Tsquash/AirQualityMonitor/Production/DigikeyBOM - QTY 1.csv

Index | Quantity | Part Number | Manufacturer Part Number | Description | Customer Reference | Available | Backorder | Unit Price | Extended Price USD
1 | 1 | BAT-HLD-001-ND | BAT-HLD-001 | BATTERY RETAINER COIN 20MM SMD |  | 1 | 0 | 0.38000 | 0.38
2 | 12 | 399-C0603C105K4RACTUCT-ND | C0603C105K4RACTU | CAP CER 1UF 16V X7R 0603 |  | 12 | 0 | 0.01100 | 0.13
3 | 10 | 1276-1784-1-ND | CL10A475KO8NNNC | CAP CER 4.7UF 16V X5R 0603 |  | 10 | 0 | 0.01400 | 0.14
4 | 1 | 1276-CL10E104KC8VPNCCT-ND | CL10E104KC8VPNC | CAP CER 100NF 100V X8L 0603 |  | 1 | 0 | 0.25000 | 0.25
5 | 1 | 1276-6769-1-ND | CL10X106MO8NRNC | CAP CER 10UF 16V X6S 0603 |  | 1 | 0 | 0.11000 | 0.11
6 | 2 | 1276-CL10E224KA84PNCCT-ND | CL10E224KA84PNC | CAP CER 220NF 25V X8L 0603 |  | 2 | 0 | 0.16000 | 0.32
7 | 3 | 5399-1N5819WCT-ND | 1N5819W | 40V INDEPENDENT TYPE 1A 900MV@3A |  | 3 | 0 | 0.10000 | 0.30
8 | 1 | 26-FH34SRJ-24S-0.5SH(50)CT-ND | FH34SRJ-24S-0.5SH(50) | CONN FFC FPC 24POS 0.5MM R/A |  | 1 | 0 | 1.01000 | 1.01
9 | 1 | 2223-UJ20-C-V-C-1-SMT-TRCT-ND | UJ20-C-V-C-1-SMT-TR | USB JACK 2.0, TYPE-C, VERTICAL, |  | 1 | 0 | 0.76000 | 0.76
10 | 1 | 587-1816-1-ND | LBM2016T680J | FIXED IND 68UH 90MA 7 OHM SMD |  | 1 | 0 | 0.12000 | 0.12
11 | 1 | SI1308EDL-T1-GE3CT-ND | SI1308EDL-T1-GE3 | MOSFET N-CH 30V 1.4A SOT323 |  | 1 | 0 | 0.58000 | 0.58
12 | 10 | 311-4.70KHRCT-ND | RC0603FR-074K7L | RES 4.7K OHM 1% 1/10W 0603 |  | 10 | 0 | 0.00900 | 0.09
13 | 1 | 60-73L2R47JCT-ND | 73L2R47J | RES 0.47 OHM 5% 1/10W 0603 |  | 1 | 0 | 0.10000 | 0.10
14 | 10 | 311-10.0KHRCT-ND | RC0603FR-0710KL | RES 10K OHM 1% 1/10W 0603 |  | 10 | 0 | 0.00600 | 0.06
15 | 25 | 311-100KHRCT-ND | RC0603FR-07100KL | RES 100K OHM 1% 1/10W 0603 |  | 25 | 0 | 0.00520 | 0.13
16 | 1 | 311-4.7GRCT-ND | RC0603JR-074R7L | RES 4.7 OHM 5% 1/10W 0603 |  | 1 | 0 | 0.10000 | 0.10
17 | 10 | 311-5.10KHRCT-ND | RC0603FR-075K1L | RES 5.1K OHM 1% 1/10W 0603 |  | 10 | 0 | 0.00700 | 0.07
18 | 2 | EG4389CT-ND | TL3330AF260QG | SWITCH TACTILE SPST-NO 0.05A 12V |  | 2 | 0 | 0.53000 | 1.06
19 | 1 | 1649-SCD41-D-R2CT-ND | SCD41-D-R2 | SENSOR AIR QUALITY I2C OUTPUT |  | 1 | 0 | 19.76000 | 19.76
20 | 1 | 1528-5183-ND | 5183 | DHT20 - AHT20 PIN MODULE - I2C T |  | 1 | 0 | 4.50000 | 4.50
21 | 1 | 175-MAX31328NELB+TCT-ND | MAX31328NELB+T | INTEGRATED DS3231SN W/ NDK CRYST |  | 1 | 0 | 4.94000 | 4.94
22 | 1 | 1649-SGP41-D-R4CT-ND | SGP41-D-R4 | SENSOR AIR QUALITY I2C OUTPUT |  | 1 | 0 | 8.18000 | 8.18
