Tsquash/AirQualityMonitor/2D/PCB.dxf

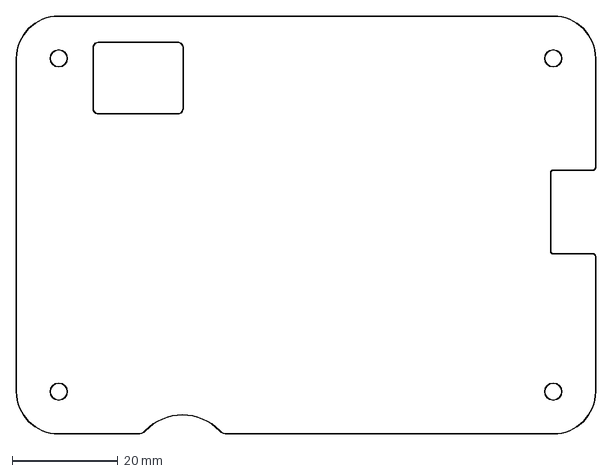
[picture p1: CAD file, 2026-10-28]
2D/PCB.dxf
109.5 x 79.0 mm
