Tsquash/AirQualityMonitor/3D/PCB Spacer.stl

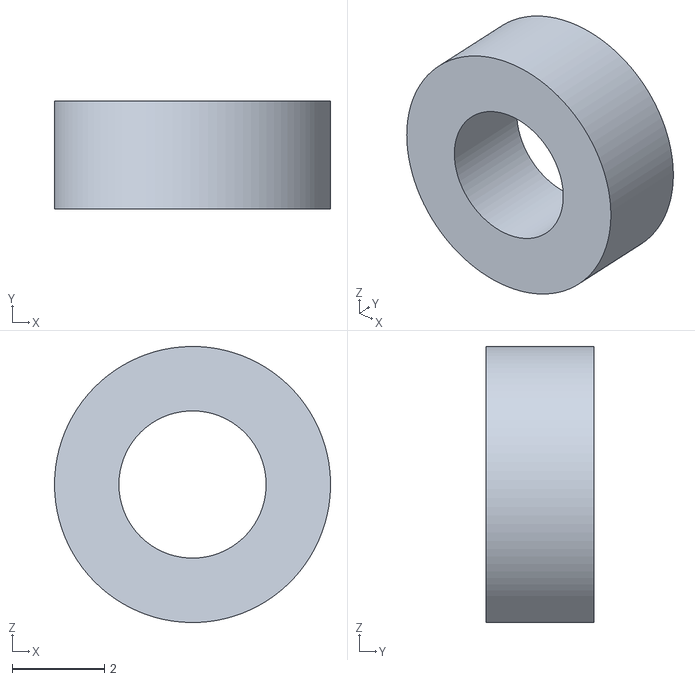
[picture p2: CAD file, 2026-10-28]
3D/PCB Spacer.stl
6.00 x 2.35 x 6.00
