Tsquash/AirQualityMonitor/KICAD/Parts/DHT/DHTVertical_Footprint.dxf

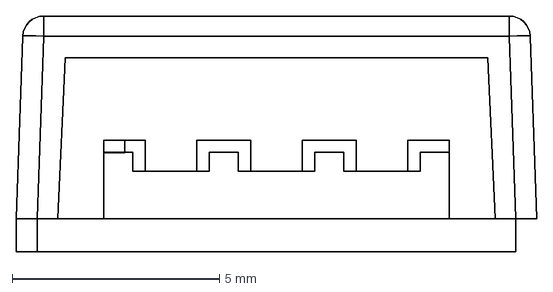
[picture p3: CAD file, 2026-10-28]
KICAD/Parts/DHT/DHTVertical_Footprint.dxf
12.6 x 5.69 mm
