Tsquash/AirQualityMonitor/KICAD/Parts/RTC/21-0140AK_L1055M-1_MXM.step

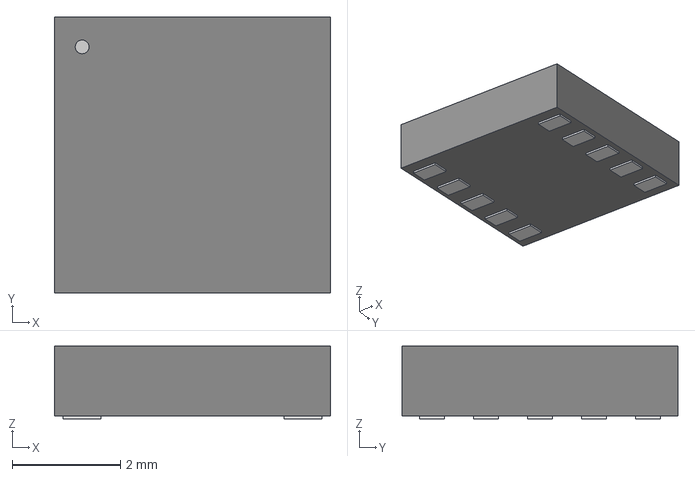
[picture p4: CAD file, 2026-10-28]
KICAD/Parts/RTC/21-0140AK_L1055M-1_MXM.step
5.11 x 5.11 x 1.35 mm
