Tsquash/AirQualityMonitor/KICAD/Parts/UJ20_C_V_C_1_SMT_TR/UJ20-C-V-C-1-SMT-TR.step

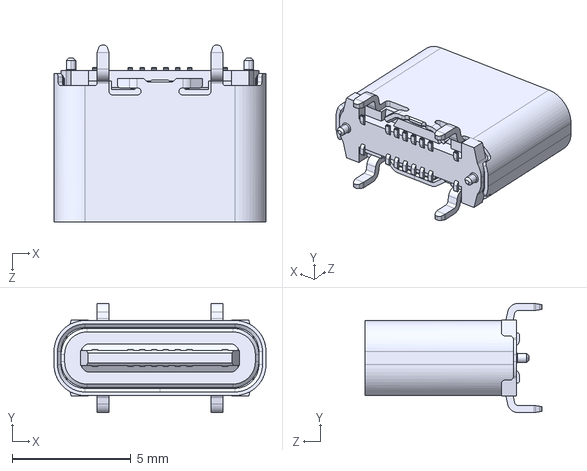
[picture p5: CAD file, 2026-10-28]
KICAD/Parts/UJ20_C_V_C_1_SMT_TR/UJ20-C-V-C-1-SMT-TR.step
8.94 x 4.60 x 7.45 mm
