Tsquash/AirQualityMonitor/2D/3.7EPD.dxf

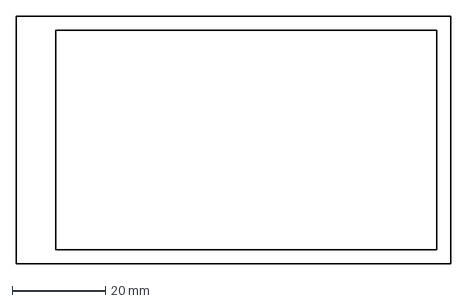
[picture p6: CAD file, 2026-10-28]
2D/3.7EPD.dxf
93.0 x 53.0 mm
