Tsquash/AirQualityMonitor/3D/PCB.step

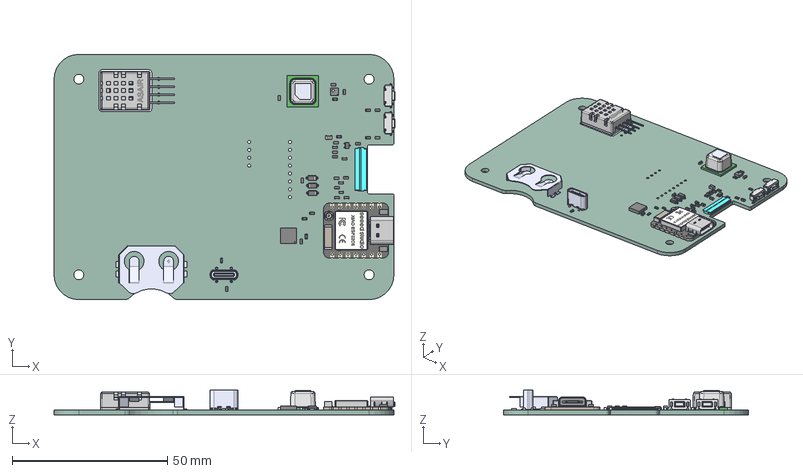
[picture p7: CAD file, 2026-10-28]
3D/PCB.step
109.9 x 79.0 x 8.00 mm
C_0603_1608Metric x 18
UJ20-C-V-C-1-SMT-TR
SOT-323_SC-70
21-0140AK_L1055M-1_MXM
R_0603_1608Metric x 11
FH34SRJ-24S-0.5SH
D_SOD-123 x 3
TL3330AF130QG--3DModel-STEP-520916 x 2
BAT-HLD-001
BOSS-EXTRUDE14_8_
BOSS-EXTRUDE7_4_
BOSS-EXTRUDE7_3_
BOSS-EXTRUDE14_4_
BOSS-EXTRUDE14_2_
BOSS-EXTRUDE14_11_
BOSS-EXTRUDE7_7_
BOSS-EXTRUDE14_9_
BOSS-EXTRUDE14_3_
BOSS-EXTRUDE14_7_
MIRROR2
BOSS-EXTRUDE14_5_
BOSS-EXTRUDE14_12_
BOSS-EXTRUDE7_8_
BOSS-EXTRUDE7_1_
BOSS-EXTRUDE14_10_
BOSS-EXTRUDE7_9_
BOSS-EXTRUDE14_6_
BOSS-EXTRUDE14_1_
BOSS-EXTRUDE7_6_
BOSS-EXTRUDE7_2_
CUT-EXTRUDE5
BOSS-EXTRUDE7_5_
Shield
Pins x 2
U.FL-R-SMT-1_10_ v1
L_0805_2012Metric
ASAIR DHT20 SIP
SCD41-D-R2
SGP41-D-R4
AirQuality_PCB
