Tsquash/AirQualityMonitor/KICAD/Parts/DHT/DHT20 Footprint.dxf

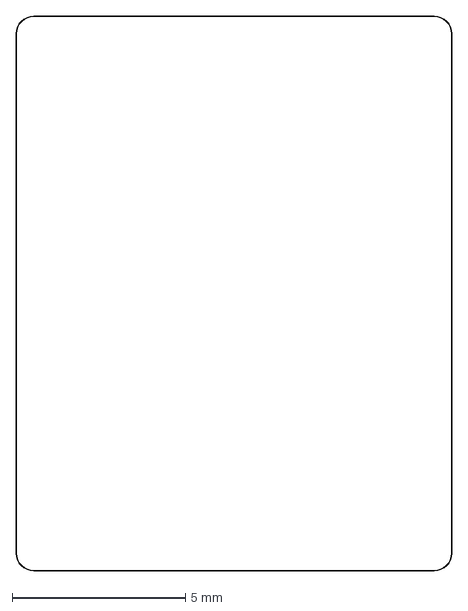
[picture p8: CAD file, 2026-10-28]
KICAD/Parts/DHT/DHT20 Footprint.dxf
12.6 x 16.0 mm
