Tsquash/AirQualityMonitor/2D/BackDXF.dxf

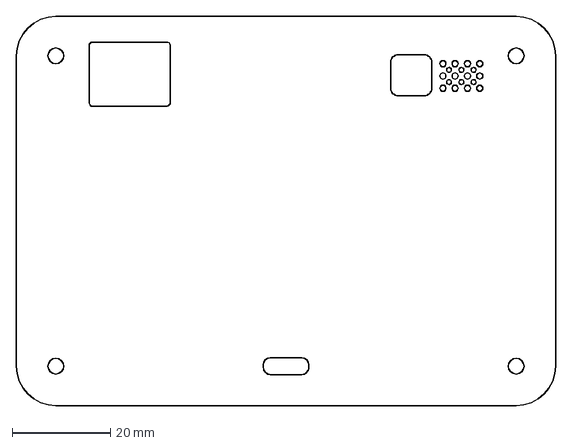
[picture p9: CAD file, 2026-10-28]
2D/BackDXF.dxf
109.5 x 79.0 mm
