Tsquash/AirQualityMonitor/3D/Back Spacer.stl

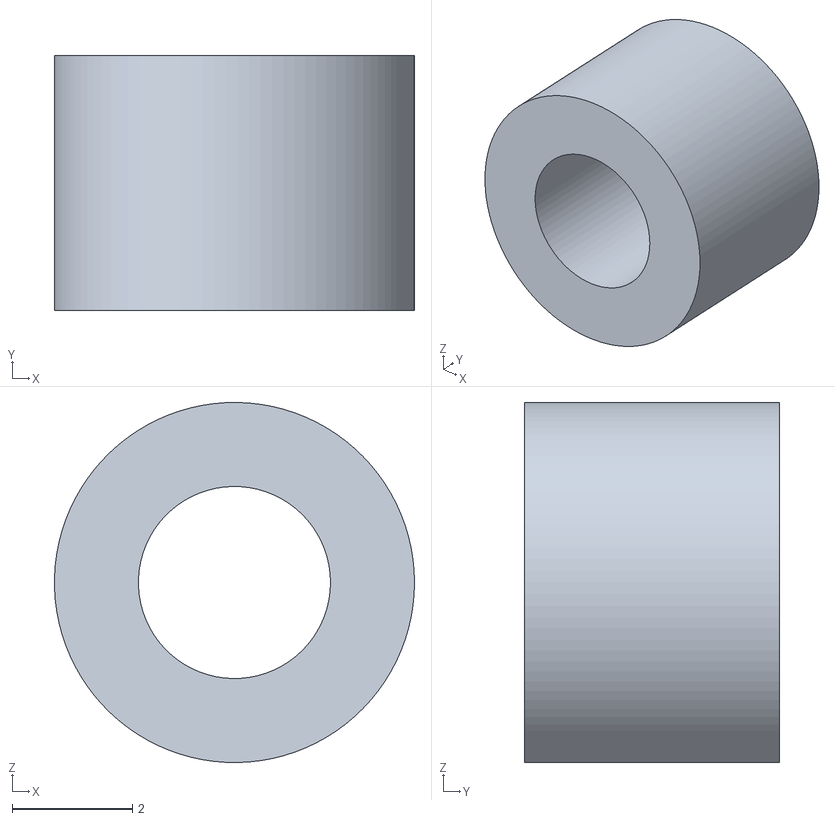
[picture p10: CAD file, 2026-10-28]
3D/Back Spacer.stl
6.00 x 4.25 x 6.00
