Tsquash/AirQualityMonitor/KICAD/Parts/DHT/ASAIR DHT20 SIP .step

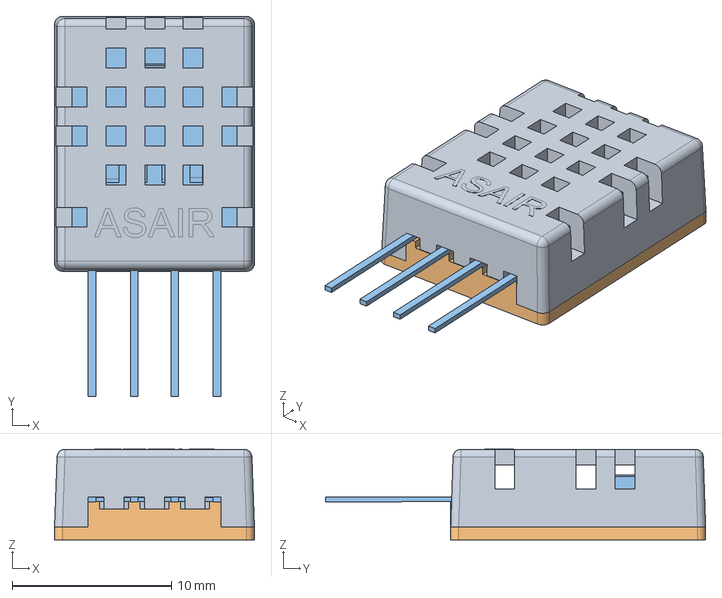
[picture p11: CAD file, 2026-10-28]
KICAD/Parts/DHT/ASAIR DHT20 SIP .step
12.6 x 23.9 x 5.71 mm
