Tsquash/AirQualityMonitor/2D/FrontDXF.dxf

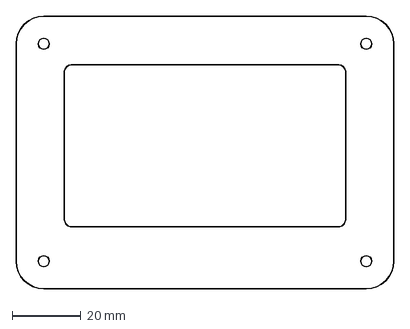
[picture p12: CAD file, 2026-10-28]
2D/FrontDXF.dxf
109.5 x 79.0 mm
