Tsquash/AirQualityMonitor/KICAD/AirQuality.kicad_pcb

## KiCad design KICAD/AirQuality.kicad_pcb (2026-10-28)

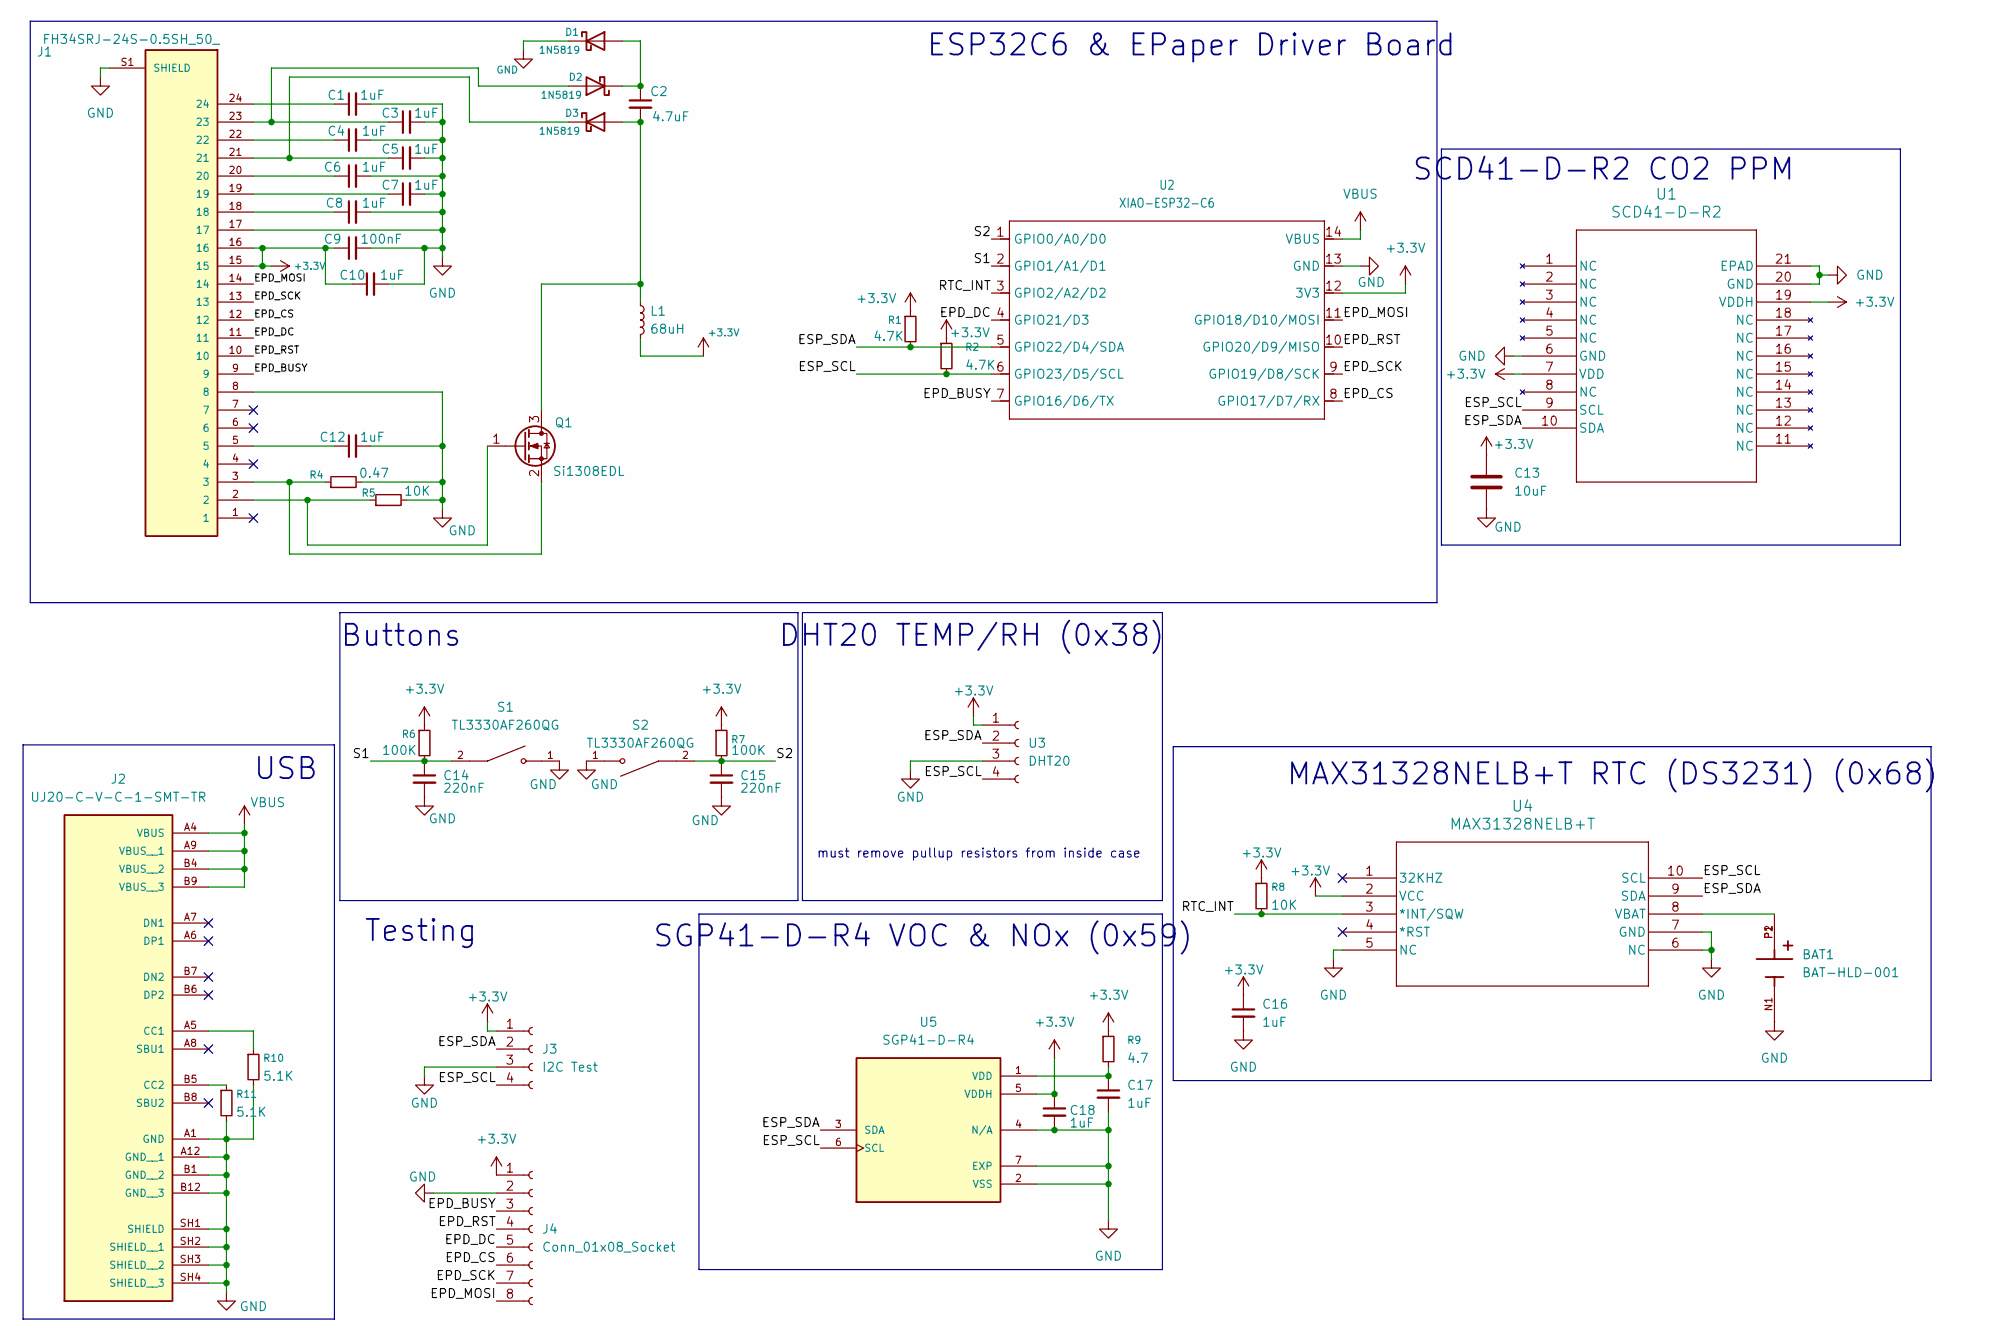
[picture p13: schematic AirQuality.kicad_sch]

Parts:
BAT1: BAT-HLD-001; BAT_BAT-HLD-001; PARTREV C
C1, C3, C4, C5, C6, C7, C8, C10, C12, C16, C17, C18: 1uF; C_0603_1608Metric
C2: 4.7uF; C_0603_1608Metric
C9: 100nF; C_0603_1608Metric
C13: 10uF; C_0603_1608Metric
C14, C15: 220nF; C_0603_1608Metric
D1, D2, D3: 1N5819; D_SOD-123
J1: FH34SRJ-24S-0.5SH_50_; HRS_FH34SRJ-24S-0.5SH_50_
J2: UJ20-C-V-C-1-SMT-TR; CUI_UJ20-C-V-C-1-SMT-TR; PARTREV 1.0
J3: I2C Test; PinHeader_1x04_P2.54mm_Vertical
J4: Conn_01x08_Socket; PinHeader_1x08_P2.54mm_Vertical
L1: 68uH; L_0805_2012Metric
Q1: Si1308EDL; SOT-323_SC-70
R1, R2: 4.7K; R_0603_1608Metric
R4: 0.47; R_0603_1608Metric
R5, R8: 10K; R_0603_1608Metric
R6, R7: 100K; R_0603_1608Metric
R9: 4.7; R_0603_1608Metric
R10, R11: 5.1K; R_0603_1608Metric
S1, S2: TL3330AF260QG; SW_TL3330AF260QG; PARTREV B
U1: SCD41-D-R2; QFN20_SCD41-D-R2_SEN
U2: XIAO-ESP32-C6; XIAO-ESP32C6-DIP
U3: DHT20; PinHeader_1x04_P2.54mm_Vertical
U4: MAX31328NELB+T; 21-0140AK_L1055M-1_MXM
U5: SGP41-D-R4; XDCR_SGP41-D-R4; PARTREV 1.0

Connections:
+3.3V: C9.1, C10.1, C13.1, C16.1, C18.1, J1.15, J1.16, J3.1, J4.1, L1.2, R1.1, R2.1, R6.1, R7.1, R8.1, R9.1, U1.7 (VDD), U1.19 (VDDH), U2.12 (3V3), U3.1, U4.2 (VCC), U5.5 (VDDH); also elsewhere on the board
/EPD_BUSY: J1.9, J4.3, U2.7 (GPIO16/D6/TX)
/EPD_CS: J1.12, J4.6, U2.8 (GPIO17/D7/RX)
/EPD_DC: J1.11, J4.5, U2.4 (GPIO21/D3)
/EPD_MOSI: J1.14, J4.8, U2.11 (GPIO18/D10/MOSI)
/EPD_RST: J1.10, J4.4, U2.10 (GPIO20/D9/MISO)
/EPD_SCK: J1.13, J4.7, U2.9 (GPIO19/D8/SCK)
/ESP_SCL: J3.4, R2.2, U1.9 (SCL), U2.6 (GPIO23/D5/SCL), U3.4, U4.10 (SCL), U5.6 (SCL)
/ESP_SDA: J3.2, R1.2, U1.10 (SDA), U2.5 (GPIO22/D4/SDA), U3.2, U4.9 (SDA), U5.3 (SDA)
/RTC_INT: R8.2, U2.3 (GPIO2/A2/D2), U4.3 (*INT/SQW)
/S1: C14.1, R6.2, S1.2, U2.2 (GPIO1/A1/D1)
/S2: C15.1, R7.2, S2.2, U2.1 (GPIO0/A0/D0)
GND: BAT1.N1, C1.2, C3.2, C4.2, C5.2, C6.2, C7.2, C8.2, C9.2, C10.2, C12.2, C13.2, C14.2, C15.2, C16.2, C17.2, C18.2, D1.1 (K), J1.8, J1.17, J1.S1 (SHIELD), J1.S2 (SHIELD), J2.A1 (GND), J2.A12 (GND__1), J2.B1 (GND__2), J2.B12 (GND__3), J2.SH1 (SHIELD), J2.SH2 (SHIELD__1), J2.SH3 (SHIELD__2), J2.SH4 (SHIELD__3), J3.3, J4.2, R4.2, R5.2, R10.2, R11.2, S1.1, S2.1, U1.6 (GND), U1.20 (GND), U1.21 (EPAD), U2.13 (GND), U3.3, U4.5 (NC), U4.6 (NC), U4.7 (GND), U5.2 (VSS), U5.4 (N/A), U5.7 (EXP); also elsewhere on the board
unnamed: C1.1, J1.24
unnamed: C4.1, J1.22
unnamed: C6.1, J1.20
unnamed: C7.1, J1.19
unnamed: C8.1, J1.18
unnamed: C12.1, J1.5
unnamed: C2.1, D1.2 (A), D2.1 (K)
unnamed: C3.1, D2.2 (A), J1.23
unnamed: C2.2, D3.2 (A), L1.1, Q1.3 (D)
unnamed: C5.1, D3.1 (K), J1.21
unnamed 23: J1.4; also elsewhere on the board
unnamed: J2.A5 (CC1), R10.1
unnamed: J2.B5 (CC2), R11.1
unnamed: J1.2, Q1.1 (G), R5.1
unnamed: J1.3, Q1.2 (S), R4.1
unnamed: BAT1.P1, BAT1.P2, U4.8 (VBAT)
unnamed: C17.1, R9.2, U5.1 (VDD)
VBUS: J2.A4 (VBUS), J2.A9 (VBUS__1), J2.B4 (VBUS__2), J2.B9 (VBUS__3), U2.14 (VBUS)

Notes on the sheet:
SGP41-D-R4 VOC & NOx (0x59)
ESP32C6 & EPaper Driver Board
DHT20 TEMP/RH (0x38)
USB
Buttons
Testing
MAX31328NELB+T RTC (DS3231) (0x68)
SCD41-D-R2 CO2 PPM
must remove pullup resistors from inside case

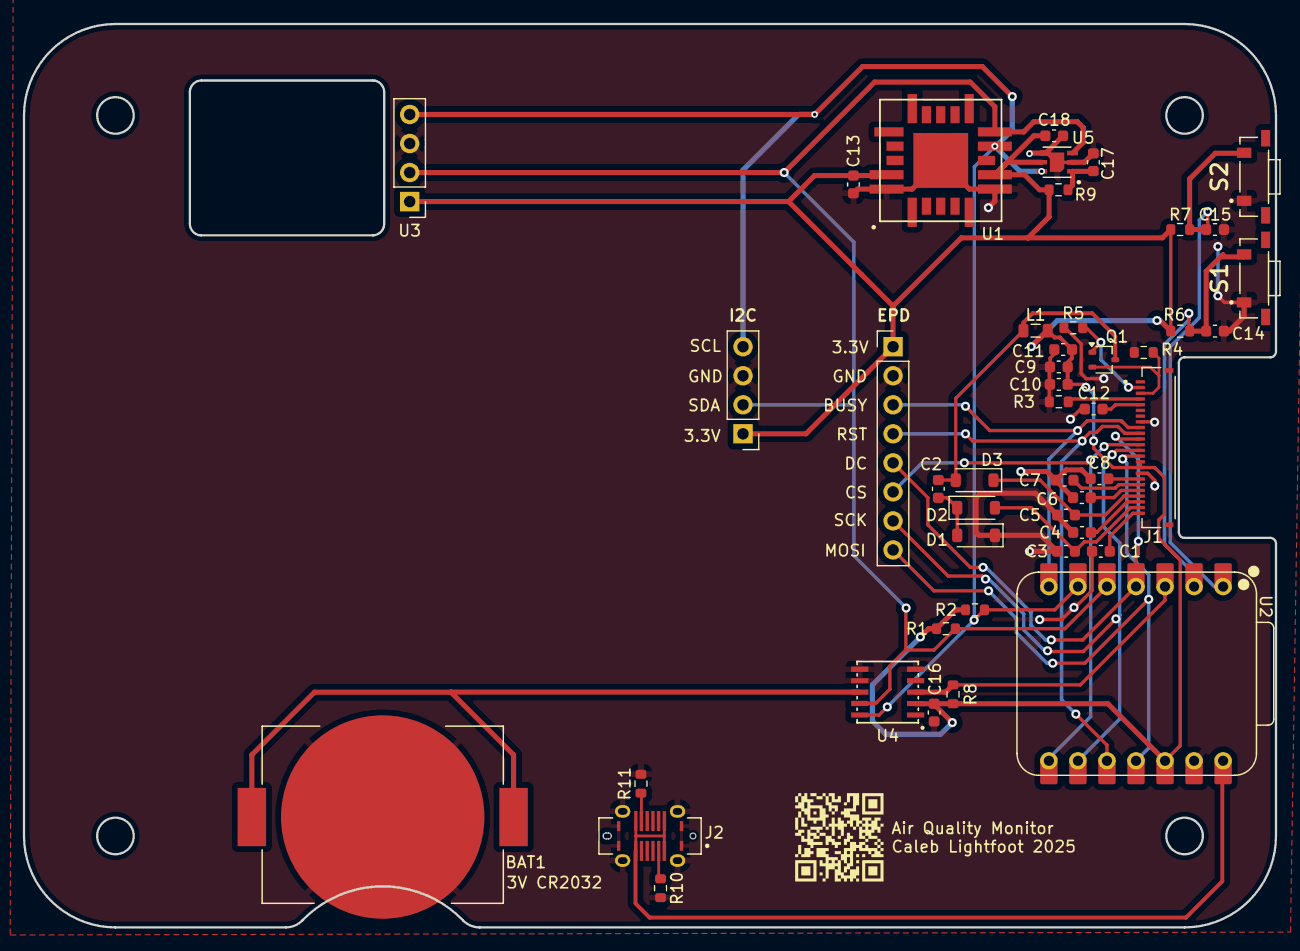
[picture p14: board AirQuality.kicad_pcb from above]

Board: 4 copper layers, 109.5 x 79.0 mm, 46 parts (0 on the bottom side), 31 nets.

Other parts of the board:
C11: 4.7uF; C_0603_1608Metric
R3: 0; R_0603_1608Metric

Their connections:
+3.3V: C11.1; also elsewhere on the board
GND: C11.2, R3.2; also elsewhere on the board
unnamed 23: R3.1; also elsewhere on the board
