Tsquash/AirQualityMonitor/main/matter_air_quality_sensor.cpp

#include "sense.h"
#include "pm_link.h"
#include "matter_air_quality_sensor.h"
#include <platform/CHIPDeviceLayer.h>

float AirQualitySensor::getTemperature() { return tempC; }
float AirQualitySensor::getHumidity() { return (float)RH; }     
float AirQualitySensor::getCO2() { return (float)CO2; }
int32_t AirQualitySensor::getVOCIndex() { return VOC; }
int32_t AirQualitySensor::getNOxIndex() { return NOx; }

using namespace esp_matter;
using namespace esp_matter::endpoint;
using namespace chip::app::Clusters;
using namespace esp_matter::cluster; 

MatterAirQualitySensor::MatterAirQualitySensor(endpoint_t* endpoint, std::shared_ptr<AirQualitySensor> airQualitySensor)
    : m_endpoint(endpoint), m_airQualitySensor(airQualitySensor) {}

std::shared_ptr<MatterAirQualitySensor> MatterAirQualitySensor::CreateEndpoint(
    node_t* node, 
    std::shared_ptr<AirQualitySensor> airQualitySensor) 
{
    // 1. Create the base Air Quality Endpoint
    air_quality_sensor::config_t air_quality_config;
    endpoint_t* endpoint = air_quality_sensor::create(node, &air_quality_config, ENDPOINT_FLAG_NONE, nullptr);

    if (!endpoint) {
        log_e("Failed to create Air Quality endpoint!");
        return nullptr;
    }

    // Advertise every AirQuality enum value used by our six-band calculation.
    cluster_t *quality_cluster = cluster::get(endpoint, AirQuality::Id);
    // This SDK's feature helper declarations do not match their linked names.
    // These four bits enable Fair, Moderate, VeryPoor, and ExtremelyPoor.
    attribute_t *quality_features = attribute::get(quality_cluster, Globals::Attributes::FeatureMap::Id);
    esp_matter_attr_val_t quality_feature_value = esp_matter_uint32(0x0F);
    if (!quality_features || attribute::set_val(quality_features, &quality_feature_value) != ESP_OK)
        return nullptr;

    // 2. Add Device Types
    endpoint::add_device_type(endpoint, 0x0302, 1); // Temperature Sensor
    endpoint::add_device_type(endpoint, 0x0307, 1); // Humidity Sensor

    // -------------------------------------------------------------------------
    // TEMPERATURE
    // -------------------------------------------------------------------------
    temperature_measurement::config_t temp_config;
    temp_config.measured_value = nullable<int16_t>(0);
    temp_config.min_measured_value = nullable<int16_t>(-4000);
    temp_config.max_measured_value = nullable<int16_t>(8500);
    cluster_t *temp_cluster = temperature_measurement::create(endpoint, &temp_config, CLUSTER_FLAG_SERVER);
    if (!temp_cluster)
        return nullptr;

    // -------------------------------------------------------------------------
    // HUMIDITY
    // -------------------------------------------------------------------------
    relative_humidity_measurement::config_t humid_config;
    humid_config.measured_value = nullable<uint16_t>(0);
    humid_config.min_measured_value = nullable<uint16_t>(0);
    humid_config.max_measured_value = nullable<uint16_t>(10000);
    cluster_t *humid_cluster = relative_humidity_measurement::create(endpoint, &humid_config, CLUSTER_FLAG_SERVER);
    if (!humid_cluster)
        return nullptr;

    // -------------------------------------------------------------------------
    // CO2 (Concentration Measurement)
    // -------------------------------------------------------------------------
    carbon_dioxide_concentration_measurement::config_t co2_config;

    cluster_t *co2_cluster = carbon_dioxide_concentration_measurement::create(endpoint, &co2_config, CLUSTER_FLAG_SERVER);

    // Enable NumericMeasurement, LevelIndication, MediumLevel, and CriticalLevel.
    attribute_t *featureMapAttr = attribute::get(co2_cluster, 0xFFFC); // 0xFFFC is the standard FeatureMap ID
    if (featureMapAttr) {
        esp_matter_attr_val_t val = esp_matter_uint32(0x0F);
        attribute::set_val(featureMapAttr, &val);
    }

    // Mandatory Attributes for Numeric Mode:
    attribute::create(co2_cluster, CarbonDioxideConcentrationMeasurement::Attributes::MinMeasuredValue::Id, ATTRIBUTE_FLAG_NULLABLE, esp_matter_float(0.0));
    attribute::create(co2_cluster, CarbonDioxideConcentrationMeasurement::Attributes::MaxMeasuredValue::Id, ATTRIBUTE_FLAG_NULLABLE, esp_matter_float(5000.0));
    attribute::create(co2_cluster, CarbonDioxideConcentrationMeasurement::Attributes::MeasuredValue::Id, ATTRIBUTE_FLAG_NULLABLE, esp_matter_float(0.0));

    // Measurement Unit (0x0004) -> PPM (0)
    attribute::create(co2_cluster, CarbonDioxideConcentrationMeasurement::Attributes::MeasurementUnit::Id, ATTRIBUTE_FLAG_NULLABLE, esp_matter_uint8(0));

    // Add VOC and NOx clusters to the Matter endpoint
    // -------------------------------------------------------------------------
    // VOC (tVOC Measurement)
    // -------------------------------------------------------------------------
    total_volatile_organic_compounds_concentration_measurement::config_t voc_config;
    cluster_t *voc_cluster = total_volatile_organic_compounds_concentration_measurement::create(
        endpoint, &voc_config, CLUSTER_FLAG_SERVER);

    attribute_t *vocFeatureMapAttr = attribute::get(voc_cluster, 0xFFFC);
    if (vocFeatureMapAttr) {
        esp_matter_attr_val_t val = esp_matter_uint32(0x0F);
        attribute::set_val(vocFeatureMapAttr, &val);
    }

    attribute::create(voc_cluster, TotalVolatileOrganicCompoundsConcentrationMeasurement::Attributes::MinMeasuredValue::Id,
                      ATTRIBUTE_FLAG_NULLABLE, esp_matter_float(1.0));
    attribute::create(voc_cluster, TotalVolatileOrganicCompoundsConcentrationMeasurement::Attributes::MaxMeasuredValue::Id,
                      ATTRIBUTE_FLAG_NULLABLE, esp_matter_float(500.0));
    attribute::create(voc_cluster, TotalVolatileOrganicCompoundsConcentrationMeasurement::Attributes::MeasuredValue::Id,
                      ATTRIBUTE_FLAG_NULLABLE, esp_matter_float(1.0));
    attribute::create(voc_cluster, TotalVolatileOrganicCompoundsConcentrationMeasurement::Attributes::MeasurementUnit::Id,
                      ATTRIBUTE_FLAG_NULLABLE, esp_matter_uint8(4)); // ug/m3
    attribute::create(voc_cluster, TotalVolatileOrganicCompoundsConcentrationMeasurement::Attributes::MeasurementMedium::Id,
                      ATTRIBUTE_FLAG_NULLABLE, esp_matter_uint8(0)); // air

    // -------------------------------------------------------------------------
    // NOx (NO2 Measurement)
    // -------------------------------------------------------------------------
    nitrogen_dioxide_concentration_measurement::config_t nox_config;
    cluster_t *nox_cluster = nitrogen_dioxide_concentration_measurement::create(
        endpoint, &nox_config, CLUSTER_FLAG_SERVER);

    attribute_t *noxFeatureMapAttr = attribute::get(nox_cluster, 0xFFFC);
    if (noxFeatureMapAttr) {
        esp_matter_attr_val_t val = esp_matter_uint32(0x0F);
        attribute::set_val(noxFeatureMapAttr, &val);
    }

    attribute::create(nox_cluster, NitrogenDioxideConcentrationMeasurement::Attributes::MinMeasuredValue::Id,
                      ATTRIBUTE_FLAG_NULLABLE, esp_matter_float(1.0));
    attribute::create(nox_cluster, NitrogenDioxideConcentrationMeasurement::Attributes::MaxMeasuredValue::Id,
                      ATTRIBUTE_FLAG_NULLABLE, esp_matter_float(500.0));
    attribute::create(nox_cluster, NitrogenDioxideConcentrationMeasurement::Attributes::MeasuredValue::Id,
                      ATTRIBUTE_FLAG_NULLABLE, esp_matter_float(1.0));
    attribute::create(nox_cluster, NitrogenDioxideConcentrationMeasurement::Attributes::MeasurementUnit::Id,
                      ATTRIBUTE_FLAG_NULLABLE, esp_matter_uint8(4)); // ug/m3 (wrong unit :( only one that works)
    attribute::create(nox_cluster, NitrogenDioxideConcentrationMeasurement::Attributes::MeasurementMedium::Id,
                      ATTRIBUTE_FLAG_NULLABLE, esp_matter_uint8(0)); // air

    // PM1 in ug/m3, numeric measurement only.
    pm1_concentration_measurement::config_t pm1_config;
    cluster_t *pm1_cluster = pm1_concentration_measurement::create(endpoint, &pm1_config, CLUSTER_FLAG_SERVER);
    pm1_concentration_measurement::feature::numeric_measurement::config_t pm1_numeric;
    pm1_numeric.measured_value = 0.0f;
    pm1_numeric.min_measured_value = 0.0f;
    pm1_numeric.max_measured_value = 1000.0f;
    pm1_numeric.measurement_unit = 4; // ug/m3; measurement medium defaults to air
    if (!pm1_cluster || pm1_concentration_measurement::feature::numeric_measurement::add(pm1_cluster, &pm1_numeric) != ESP_OK)
        return nullptr;

    // PM25 in ug/m3, numeric measurement only.
    pm25_concentration_measurement::config_t pm25_config;
    cluster_t *pm25_cluster = pm25_concentration_measurement::create(endpoint, &pm25_config, CLUSTER_FLAG_SERVER);
    pm25_concentration_measurement::feature::numeric_measurement::config_t pm25_numeric;
    pm25_numeric.measured_value = 0.0f;
    pm25_numeric.min_measured_value = 0.0f;
    pm25_numeric.max_measured_value = 1000.0f;
    pm25_numeric.measurement_unit = 4; // ug/m3; measurement medium defaults to air
    if (!pm25_cluster || pm25_concentration_measurement::feature::numeric_measurement::add(pm25_cluster, &pm25_numeric) != ESP_OK)
        return nullptr;

    // PM10 in ug/m3, numeric measurement only.
    pm10_concentration_measurement::config_t pm10_config;
    cluster_t *pm10_cluster = pm10_concentration_measurement::create(endpoint, &pm10_config, CLUSTER_FLAG_SERVER);
    pm10_concentration_measurement::feature::numeric_measurement::config_t pm10_numeric;
    pm10_numeric.measured_value = 0.0f;
    pm10_numeric.min_measured_value = 0.0f;
    pm10_numeric.max_measured_value = 1000.0f;
    pm10_numeric.measurement_unit = 4; // ug/m3; measurement medium defaults to air
    if (!pm10_cluster || pm10_concentration_measurement::feature::numeric_measurement::add(pm10_cluster, &pm10_numeric) != ESP_OK)
        return nullptr;

    return std::make_shared<MatterAirQualitySensor>(endpoint, airQualitySensor);
}

void MatterAirQualitySensor::UpdateMeasurements() {
    if (!m_airQualitySensor) return;

    // --- Temperature ---
    float temperature = m_airQualitySensor->getTemperature();
    int16_t temp_matter = static_cast<int16_t>(temperature * 100);
    UpdateAttribute(TemperatureMeasurement::Id, TemperatureMeasurement::Attributes::MeasuredValue::Id, temp_matter);

    // --- Humidity ---
    float humidity = m_airQualitySensor->getHumidity();
    uint16_t hum_matter = static_cast<uint16_t>(humidity * 100);
    UpdateAttribute(RelativeHumidityMeasurement::Id, RelativeHumidityMeasurement::Attributes::MeasuredValue::Id, hum_matter);

    // --- CO2 ---
    float co2 = m_airQualitySensor->getCO2();
    UpdateAttribute(CarbonDioxideConcentrationMeasurement::Id, CarbonDioxideConcentrationMeasurement::Attributes::MeasuredValue::Id, co2);

    // --- VOC ---
    float voc = static_cast<float>(m_airQualitySensor->getVOCIndex());
    if (voc < 1.0f) voc = 1.0f;
    if (voc > 500.0f) voc = 500.0f;
    UpdateAttribute(TotalVolatileOrganicCompoundsConcentrationMeasurement::Id,
                    TotalVolatileOrganicCompoundsConcentrationMeasurement::Attributes::MeasuredValue::Id,
                    voc);

    // --- NOx ---
    float nox = static_cast<float>(m_airQualitySensor->getNOxIndex());
    if (nox < 1.0f) nox = 1.0f;
    if (nox > 500.0f) nox = 500.0f;
    UpdateAttribute(NitrogenDioxideConcentrationMeasurement::Id,
                    NitrogenDioxideConcentrationMeasurement::Attributes::MeasuredValue::Id,
                    nox);

    UpdateAttribute(Pm1ConcentrationMeasurement::Id, Pm1ConcentrationMeasurement::Attributes::MeasuredValue::Id, static_cast<float>(remotePM.pm1));
    UpdateAttribute(Pm25ConcentrationMeasurement::Id, Pm25ConcentrationMeasurement::Attributes::MeasuredValue::Id, static_cast<float>(remotePM.pm25));
    UpdateAttribute(Pm10ConcentrationMeasurement::Id, Pm10ConcentrationMeasurement::Attributes::MeasuredValue::Id, static_cast<float>(remotePM.pm10));
    UpdateAttribute(AirQuality::Id, AirQuality::Attributes::AirQuality::Id, getOverallAirQuality());

}

void MatterAirQualitySensor::UpdateAttribute(uint32_t clusterId, uint32_t attributeId, float value) {
    esp_matter_attr_val_t val = esp_matter_float(value);
    
    chip::DeviceLayer::PlatformMgr().LockChipStack();
    esp_err_t err = attribute::update(endpoint::get_id(m_endpoint), clusterId, attributeId, &val);
    if (err != ESP_OK) log_e("Matter update cluster=0x%lx attribute=0x%lx failed: %s", (unsigned long)clusterId, (unsigned long)attributeId, esp_err_to_name(err));
    chip::DeviceLayer::PlatformMgr().UnlockChipStack();
}

void MatterAirQualitySensor::UpdateAttribute(uint32_t clusterId, uint32_t attributeId, uint16_t value) {
    esp_matter_attr_val_t val = esp_matter_uint16(value);
    
    chip::DeviceLayer::PlatformMgr().LockChipStack();
    esp_err_t err = attribute::update(endpoint::get_id(m_endpoint), clusterId, attributeId, &val);
    if (err != ESP_OK) log_e("Matter update cluster=0x%lx attribute=0x%lx failed: %s", (unsigned long)clusterId, (unsigned long)attributeId, esp_err_to_name(err));
    chip::DeviceLayer::PlatformMgr().UnlockChipStack();
}

void MatterAirQualitySensor::UpdateAttribute(uint32_t clusterId, uint32_t attributeId, int16_t value) {
    esp_matter_attr_val_t val = esp_matter_int16(value);
    
    chip::DeviceLayer::PlatformMgr().LockChipStack();
    esp_err_t err = attribute::update(endpoint::get_id(m_endpoint), clusterId, attributeId, &val);
    if (err != ESP_OK) log_e("Matter update cluster=0x%lx attribute=0x%lx failed: %s", (unsigned long)clusterId, (unsigned long)attributeId, esp_err_to_name(err));
    chip::DeviceLayer::PlatformMgr().UnlockChipStack();
}

void MatterAirQualitySensor::UpdateAttribute(uint32_t clusterId, uint32_t attributeId, uint8_t value) {
    esp_matter_attr_val_t val = esp_matter_uint8(value);
    
    chip::DeviceLayer::PlatformMgr().LockChipStack();
    esp_err_t err = attribute::update(endpoint::get_id(m_endpoint), clusterId, attributeId, &val);
    if (err != ESP_OK) log_e("Matter update cluster=0x%lx attribute=0x%lx failed: %s", (unsigned long)clusterId, (unsigned long)attributeId, esp_err_to_name(err));
    chip::DeviceLayer::PlatformMgr().UnlockChipStack();
}
