Tsquash/AirQualityMonitor/main/myBitmap/bitmaps.h

#pragma once
#include <Adafruit_GFX.h>

#define TEMP_HEIGHT 24
#define TEMP_WIDTH 12

const unsigned char  tempBitmap[] PROGMEM = {
  0x06, 0x00, 0x0F, 0x00, 0x19, 0x80, 0x19, 0x80, 0x19, 0x80, 0x1B, 0x80, 0x19, 0x80, 0x19, 0x80, 0x1B, 0x80, 0x19, 0x80, 0x19, 0x80, 0x1F, 0x80, 0x1F, 0x80, 0x3F, 0xC0, 0x7F, 0xE0, 0x7F, 0xE0, 0xFF, 0xF0, 0xFF, 0xF0, 0xFF, 0xF0, 0x7F, 0xE0, 0x7F, 0xE0, 0x7F, 0xE0, 0x1F, 0x80, 0x06, 0x00
};

#define HUMIDITY_HEIGHT 23
#define HUMIDITY_WIDTH 18

const unsigned char humidityBitmap[] PROGMEM = {
  0x00, 0xC0, 0x00, 0x01, 0xE0, 0x00, 0x03, 0x30, 0x00, 0x06, 0x18, 0x00, 0x0C, 0x0C, 0x00, 0x18, 0x06, 0x00, 0x30, 0x03, 0x00, 0x30, 0x03, 0x00, 0x60, 0x01, 0x80, 0xC0, 0x00, 0xC0, 0xC0, 0x00, 0xC0, 0xC0, 0x00, 0xC0, 0xC0, 0x00, 0xC0, 0xC0, 0x00, 0xC0, 0xC8, 0x00, 0xC0, 0xC8, 0x00, 0xC0, 0xCC, 0x00, 0xC0, 0x67, 0x01, 0x80, 0x71, 0xC3, 0x80, 0x30, 0x03, 0x00, 0x1E, 0x1E, 0x00, 0x0F, 0xFC, 0x00, 0x01, 0xE0, 0x00
};

#define CO2_HEIGHT 14
#define CO2_WIDTH 29 
const unsigned char co2Bitmap[] PROGMEM = {
  0x7E, 0x0F, 0xC0, 0x00, 0xFE, 0x1F, 0xE0, 0x00, 0xFE, 0x1F, 0xE0, 0x00, 0xC0, 0x18, 0xE0, 0x00, 0xC0, 0x18, 0xE0, 0x00, 0xC0, 0x18, 0xE3, 0xF0, 0xC0, 0x18, 0xE3, 0xF8, 0xFE, 0x1F, 0xE0, 0x18, 0xFE, 0x1F, 0xE0, 0x18, 0x7E, 0x0F, 0xC1, 0xF8, 0x00, 0x00, 0x03, 0x00, 0x00, 0x00, 0x03, 0x00, 0x00, 0x00, 0x03, 0xF0, 0x00, 0x00, 0x03, 0xF8
};

#define VOC_HEIGHT 19
#define VOC_WIDTH 18
const unsigned char vocBitmap[] PROGMEM = {
  0x00, 0xFF, 0xC0, 0x0F, 0xFF, 0xC0, 0x1F, 0x00, 0xC0, 0x38, 0x00, 0xC0, 0x70, 0x00, 0xC0, 0x60, 0x00, 0xC0, 0xC0, 0x00, 0xC0, 0xC0, 0x00, 0xC0, 0xC0, 0x60, 0xC0, 0xC0, 0xE0, 0xC0, 0xC1, 0xC0, 0xC0, 0xC3, 0x80, 0xC0, 0xC7, 0x00, 0xC0, 0xCE, 0x00, 0xC0, 0x7C, 0x01, 0x80, 0x38, 0x03, 0x00, 0x78, 0x07, 0x00, 0xEF, 0xFC, 0x00, 0xC7, 0xF8, 0x00
};

#define NOX_HEIGHT 18
#define NOX_WIDTH 18  
const unsigned char noxBitmap[] PROGMEM = {
  0x3F, 0x00, 0x00, 0x7F, 0x80, 0x00, 0xC1, 0xC0, 0xC0, 0xC0, 0xE1, 0xC0, 0x00, 0x7F, 0x80, 0x00, 0x3F, 0x00, 0x3F, 0x00, 0x00, 0x7F, 0x80, 0x00, 0xE1, 0xC0, 0xC0, 0xC0, 0xE1, 0xC0, 0x00, 0x7F, 0x80, 0x00, 0x3F, 0x00, 0x3E, 0x00, 0x00, 0x7F, 0x80, 0x00, 0xE1, 0xC0, 0xC0, 0xC0, 0xE0, 0xC0, 0x00, 0x7F, 0x80, 0x00, 0x3F, 0x00
};

#define AQ_HEIGHT 21
#define AQ_WIDTH 18
const unsigned char aqBitmap[] PROGMEM = {
  0x00, 0xC0, 0x00, 0x00, 0xC0, 0x00, 0x0C, 0x0C, 0x00, 0x0C, 0x0C, 0x00, 0x00, 0xC0, 0x00, 0xC0, 0xC0, 0xC0, 0xC0, 0x00, 0xC0, 0x0C, 0x0C, 0x00, 0x0C, 0x0C, 0x00, 0xC0, 0xC0, 0xC0, 0xC0, 0xC0, 0xC0, 0x00, 0x00, 0x00, 0x0C, 0x0C, 0x00, 0x0C, 0x0C, 0x00, 0xC0, 0xC0, 0xC0, 0xC0, 0xC0, 0xC0, 0x0C, 0x0C, 0x00, 0x0C, 0x0C, 0x00, 0x00, 0x00, 0x00, 0x00, 0xC0, 0x00, 0x00, 0xC0, 0x00
};

#define XAXIS_HEIGHT 15
#define XAXIS_WIDTH 302
// 'cautionSmall', 26x23px
const unsigned char xAxisBitmap [] PROGMEM = {
	0xC0, 0x00, 0x00, 0x00, 0x00, 0x00, 0x00, 0x00, 0x06, 0x00, 0x00, 0x00, 0x00, 0x00, 0x00, 0x00, 0x00, 0x00, 0x30, 0x00, 0x00, 0x00, 0x00, 0x00, 0x00, 0x00, 0x00, 0x01, 0x80, 0x00, 0x00, 0x00, 0x00, 0x00, 0x00, 0x00, 0x00, 0x30, 0xC0, 0x00, 0x00, 0x00, 0x00, 0x00, 0x00, 0x00, 0x06, 0x00, 0x00, 0x00,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
};

#define MATTERQR_HEIGHT 110
#define MATTERQR_WIDTH 110
const unsigned char matterQRBitmap[] PROGMEM = {
  0x7F, 0xFF, 0xFF, 0xFE, 0x00, 0xFF, 0x83, 0xFF, 0xFC, 0x00, 0xFF, 0xFF, 0xFF, 0xFC, 0xFF, 0xFF, 0xFF, 0xFE, 0x00, 0xFF, 0x87, 0xFF, 0xFE, 0x00, 0xFF, 0xFF, 0xFF, 0xFC, 0xFF, 0xFF, 0xFF, 0xFE, 0x00, 0xFF, 0x87, 0xFF, 0xFE, 0x00, 0xFF, 0xFF, 0xFF, 0xFC, 0xFF, 0xFF, 0xFF, 0xFE, 0x00, 0xFF, 0x87, 0xFF, 0xFE, 0x00, 0xFF, 0xFF, 0xFF, 0xFC, 0xFF, 0xFF, 0xFF, 0xFE, 0x00, 0xFF, 0x87, 0xFF, 0xFE, 0x00, 0xFF, 0xFF, 0xFF, 0xFC, 0xF8, 0x00, 0x00, 0x1E, 0x0F, 0x0F, 0x87, 0xC0, 0x1E, 0x00, 0xF0, 0x00, 0x00, 0x1C, 0xF8, 0x00, 0x00, 0x1E, 0x0F, 0x0F, 0x87, 0xC0, 0x1E, 0x00, 0xF0, 0x00, 0x00, 0x1C, 0xF8, 0x00, 0x00, 0x1E, 0x0F, 0x0F, 0x87, 0xC0, 0x1E, 0x00, 0xF0, 0x00, 0x00, 0x1C, 0xF8, 0x00, 0x00, 0x1E, 0x0F, 0x0F, 0x87, 0xC0, 0x1E, 0x00, 0xF0, 0x00, 0x00, 0x1C, 0xF8, 0x7F, 0xFC, 0x1E, 0x0F, 0x0F, 0x87, 0xC3, 0xC1, 0xE0, 0xF0, 0x7F, 0xFC, 0x1C, 0xF8, 0x7F, 0xFC, 0x1E, 0x0F, 0x0F, 0x87, 0xC3, 0xC1, 0xE0, 0xF0, 0x7F, 0xFC, 0x1C, 0xF8, 0x7F, 0xFC, 0x1E, 0x0F, 0x0F, 0x87, 0xC3, 0xC1, 0xE0, 0xF0, 0x7F, 0xFC, 0x1C, 0xF8, 0x7F, 0xFC, 0x1E, 0x0F, 0x0F, 0x87, 0xC3, 0xC1, 0xE0, 0xF0, 0x7F, 0xFC, 0x1C, 0xF8, 0x7F, 0xFC, 0x1E, 0x0F, 0x0F, 0x87, 0xC3, 0xE1, 0xE0, 0xF0, 0x7F, 0xFC, 0x1C, 0xF8, 0x7F, 0xFC, 0x1E, 0x0F, 0xFF, 0x87, 0xC3, 0xFF, 0xE0, 0xF0, 0x7F, 0xFC, 0x1C, 0xF8, 0x7F, 0xFC, 0x1E, 0x0F, 0xFF, 0x87, 0xC3, 0xFF, 0xE0, 0xF0, 0x7F, 0xFC, 0x1C, 0xF8, 0x7F, 0xFC, 0x1E, 0x0F, 0xFF, 0x87, 0xC3, 0xFF, 0xE0, 0xF0, 0x7F, 0xFC, 0x1C, 0xF8, 0x7F, 0xFC, 0x1E, 0x0F, 0xFF, 0x87, 0xC3, 0xFF, 0xE0, 0xF0, 0x7F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
, 0xFF, 0xFE, 0x0F, 0xF0, 0x7F, 0xFC, 0x1F, 0xE0, 0xF0, 0x78, 0x03, 0xFC, 0xFF, 0xFF, 0xFF, 0xFE, 0x0F, 0xF0, 0x7F, 0xFC, 0x1F, 0xE0, 0xF0, 0x78, 0x03, 0xFC, 0xFF, 0xFF, 0xFF, 0xFE, 0x0F, 0xF0, 0x7F, 0xFC, 0x1F, 0xE0, 0xF0, 0x78, 0x03, 0xFC
};
