Tsquash/AirQualityMonitor/main/myBitmap/pairing_bitmaps.h

#pragma once
#include <Adafruit_GFX.h>

#define PAIRING_WIDTH  64
#define PAIRING_HEIGHT 64

const unsigned char pairing_bitmap[] PROGMEM = {
  0x00, 0x00, 0x00, 0x00, 0x00, 0x00, 0x00, 0x00, 0x00, 0x00, 0x00, 0x00, 0x00, 0x00, 0x00, 0x00,
  0x00, 0x00, 0x00, 0x00, 0x00, 0x1F, 0xC0, 0x00, 0x00, 0x00, 0x00, 0x00, 0x00, 0xFF, 0xF8, 0x00,
  0x00, 0x00, 0x00, 0x00, 0x03, 0xFF, 0xFE, 0x00, 0x00, 0x00, 0x00, 0x00, 0x07, 0xE0, 0x3F, 0x00,
  0x00, 0x00, 0x00, 0x00, 0x0F, 0x80, 0x07, 0x80, 0x00, 0x00, 0x00, 0x00, 0x1E, 0x00, 0x03, 0xC0,
  0x00, 0x00, 0x00, 0x00, 0x3C, 0x3F, 0xC1, 0xE0, 0x00, 0x00, 0x00, 0x00, 0x78, 0x7F, 0xF0, 0xE0,
  0x00, 0x00, 0x00, 0x00, 0xF0, 0xFF, 0xF8, 0x70, 0x00, 0x00, 0x00, 0x01, 0xE1, 0xE0, 0x7C, 0x70,
  0x00, 0x00, 0x00, 0x03, 0xC3, 0xC0, 0x3C, 0x30, 0x00, 0x00, 0x00, 0x07, 0x87, 0x80, 0x1E, 0x38,
  0x00, 0x00, 0x00, 0x0F, 0x0F, 0x00, 0x0E, 0x38, 0x00, 0x00, 0x00, 0x1E, 0x1E, 0x00, 0x0E, 0x38,
  0x00, 0x00, 0x00, 0x3C, 0x3C, 0x00, 0x0E, 0x38, 0x00, 0x00, 0x00, 0x78, 0xF8, 0x00, 0x0E, 0x38,
  0x00, 0x00, 0x00, 0xF0, 0xF0, 0x00, 0x0E, 0x38, 0x00, 0x00, 0x01, 0xE1, 0xE0, 0x00, 0x0E, 0x38,
  0x00, 0x00, 0x03, 0xC7, 0xC0, 0x00, 0x1E, 0x78, 0x00, 0x00, 0x03, 0x87, 0x80, 0x00, 0x3C, 0x70,
  0x00, 0x00, 0x07, 0x8F, 0x80, 0x00, 0x7C, 0x70, 0x00, 0x00, 0x07, 0x1F, 0xE0, 0x00, 0xF8, 0xF0,
  0x00, 0x00, 0x0F, 0x3F, 0xF0, 0x01, 0xF1, 0xE0, 0x00, 0x00, 0x6E, 0x38, 0xFC, 0x03, 0xE3, 0xC0,
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
  0x3F, 0xC0, 0x00, 0xFF, 0xF0, 0x00, 0x00, 0x00, 0x3F, 0xE0, 0x01, 0xFF, 0xE0, 0x00, 0x00, 0x00,
  0x3F, 0xE0, 0x03, 0xFF, 0xC0, 0x00, 0x00, 0x00, 0x3F, 0xF0, 0x07, 0xFF, 0x80, 0x00, 0x00, 0x00,
  0x1F, 0xF8, 0x0F, 0xFF, 0x00, 0x00, 0x00, 0x00, 0x1F, 0xFF, 0x7F, 0xFE, 0x00, 0x00, 0x00, 0x00,
  0x0F, 0xFF, 0xFF, 0xFC, 0x00, 0x00, 0x00, 0x00, 0x0F, 0xFF, 0xFF, 0xF8, 0x00, 0x00, 0x00, 0x00,
  0x07, 0xFF, 0xFF, 0xF0, 0x00, 0x00, 0x00, 0x00, 0x03, 0xFF, 0xFF, 0xE0, 0x00, 0x00, 0x00, 0x00,
  0x01, 0xFF, 0xFF, 0xC0, 0x00, 0x00, 0x00, 0x00, 0x00, 0xFF, 0xFF, 0x80, 0x00, 0x00, 0x00, 0x00,
  0x00, 0x3F, 0xFE, 0x00, 0x00, 0x00, 0x00, 0x00, 0x00, 0x07, 0xF0, 0x00, 0x00, 0x00, 0x00, 0x00,
  0x00, 0x00, 0x00, 0x00, 0x00, 0x00, 0x00, 0x00, 0x00, 0x00, 0x00, 0x00, 0x00, 0x00, 0x00, 0x00
};
