Tsquash/AirQualityMonitor/(commit log)

2026-02-11 working matter without C02 but with temp and humidity
    [huge_app.csv, partitions.csv]
2026-02-11 reporting temperature, humidity, air quality, and CO2 over matter
2026-02-14 all readings working in homekit (VOC & NOX wrong unit)
    [partitions.csv]
2026-03-08 production code. fixed weekday issue
    [main.cpp, sense.cpp]
2026-10-28 getting code prod ready, added 2d,3d,ui,kicad,production, and a readme overhaul
